broken-giobbe/ceci/(threads)

Thread 1 (2021-04-13):

Make heating algorithm better

electricant, 2021-04-13:
Find a way (and implement it) to have the heating start for a while when the desired temperature is changed. This increases comfort.

For example:
Temperature is 17.6°C. Set point is 17.5°C and the user wants to increase the temperature to 18°C. Assuming +-0.5°C hysteresis the heating won't start until the temperature is below 17.5°C, and this may take a while. It's better to start heating right away and reevaluate the temperature later.

NOTE: the same should happen if the heating system is on and the set temperature is decreased.

electricant, 2022-03-10:
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
Done in mod_thermostat by resetting:

```
state.final_temp = state.target_temp;
state.anticipator_temp = 0.0;
```

After mode and temperature have been updated.

Closed 2022-03-10.
