broken-giobbe/ceci/cece-pcb/cece-pcb.kicad_pcb

## KiCad design cece-pcb/cece-pcb.kicad_pcb (2021-03-26, last stored version)

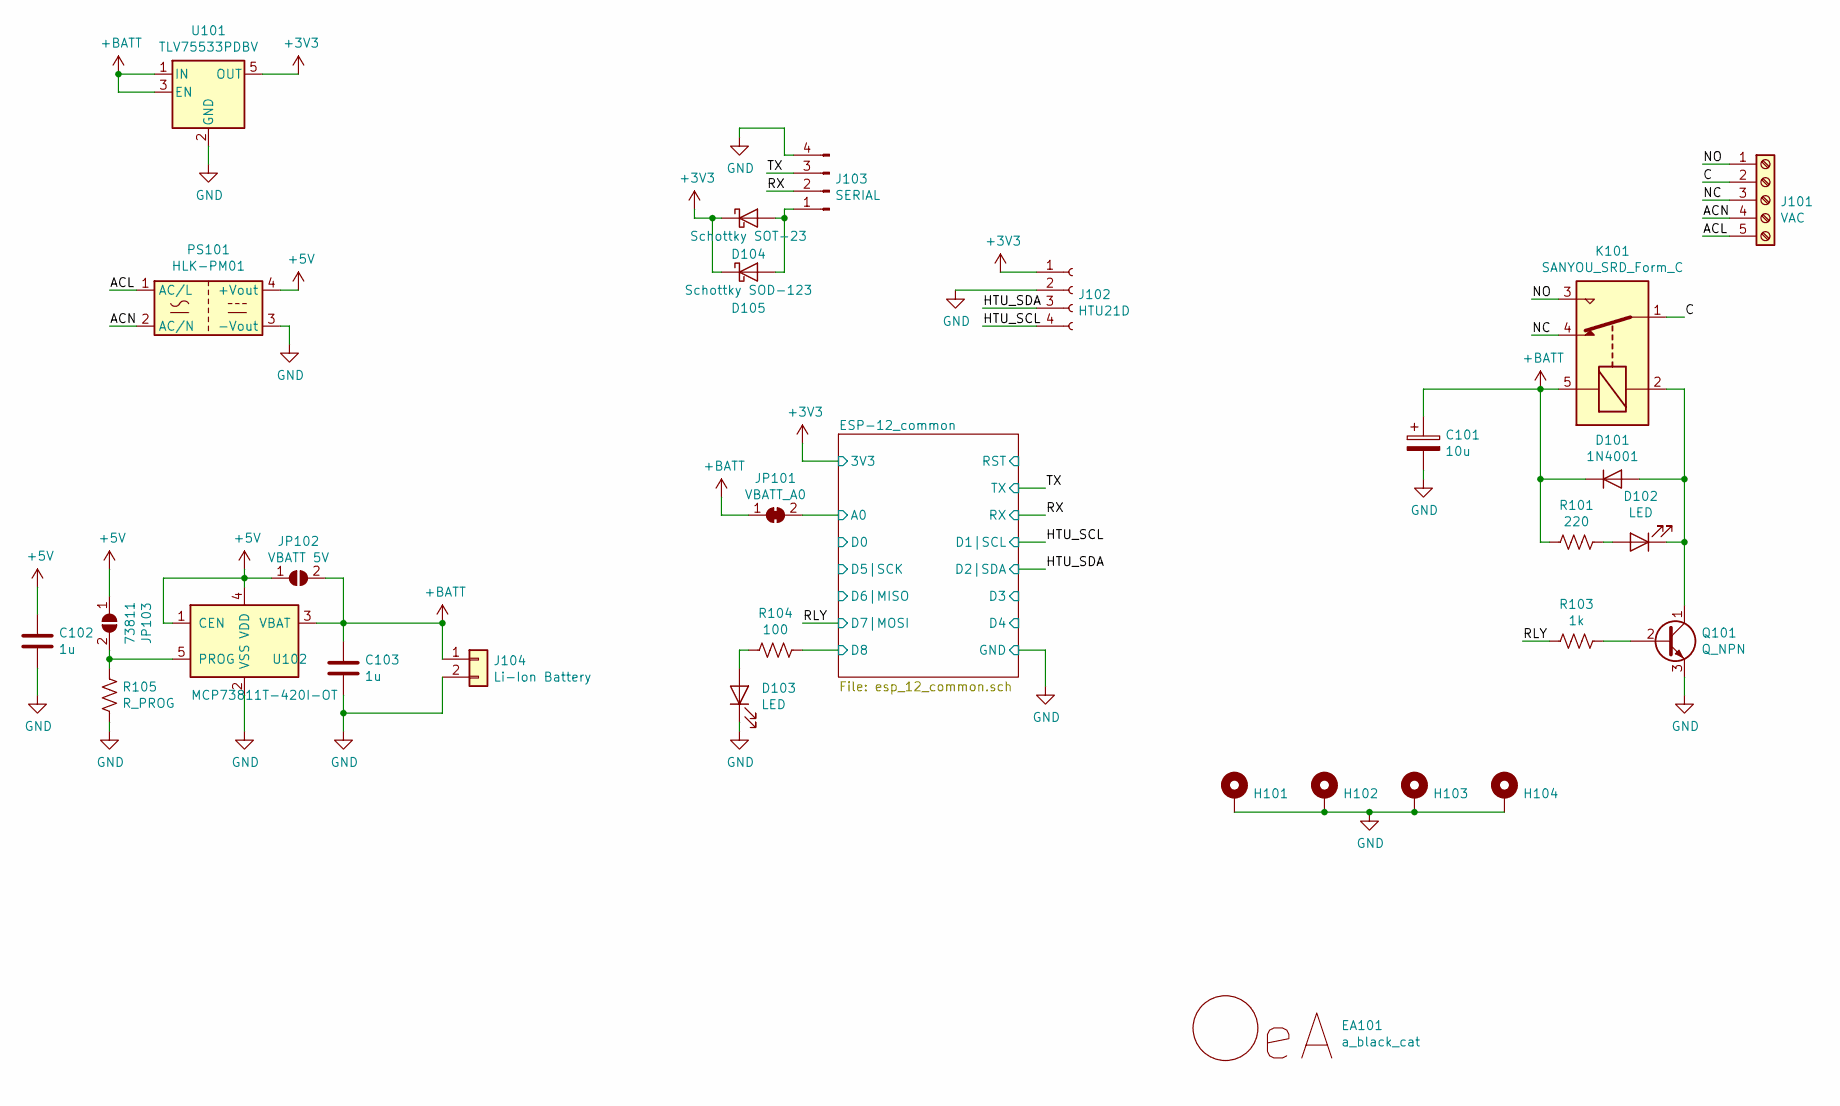
[picture p1: schematic cece-pcb.sch]

Parts:
C101: 10u; C_Radial_D6.3mm_H5.0mm_P2.50mm
C102, C103: 1u; C_Radial_D6.3mm_H5.0mm_P2.50mm
D101: 1N4001; D_DO-41_SOD81_P7.62mm_Horizontal
D102, D103: LED; LED_D3.0mm
D104: Schottky SOT-23; D_SOT-23_ANK
D105: Schottky SOD-123; D_SOD-123F
EA101: a_black_cat
H101, H102, H103, H104: MountingHole_Pad; MountingHole_3.2mm_M3_Pad
J101: VAC; TerminalBlock_bornier-5_P5.08mm
J102: HTU21D; PinHeader_1x04_P2.54mm_Vertical
J103: SERIAL; PinHeader_1x04_P2.54mm_Vertical
J104: Li-Ion Battery; PinHeader_1x02_P2.54mm_Vertical
JP101: VBATT_A0; SolderJumper-2_P1.3mm_Bridged_Pad1.0x1.5mm
JP102: VBATT 5V; SolderJumper-2_P1.3mm_Open_Pad1.0x1.5mm
JP103: 73811; SolderJumper-2_P1.3mm_Open_Pad1.0x1.5mm
K101: SANYOU_SRD_Form_C; Relay_SPDT_SANYOU_SRD_Series_Form_C
PS101: HLK-PM01; Converter_ACDC_HiLink_HLK-PMxx
Q101: Q_NPN; TO-92L_Inline_Wide
R101: 220; R_Axial_DIN0207_L6.3mm_D2.5mm_P7.62mm_Horizontal
R103: 1k; R_Axial_DIN0207_L6.3mm_D2.5mm_P7.62mm_Horizontal
R104: 100; R_Axial_DIN0207_L6.3mm_D2.5mm_P7.62mm_Horizontal
R105: R_PROG; R_0805_2012Metric_Pad1.15x1.40mm_HandSolder
U101: TLV75533PDBV; SOT-23-5
U102: MCP73811T-420I-OT; SOT-23-5

Connections:
+3V3: D104.1 (K), D105.1 (K), J102.1, U101.5 (OUT); also elsewhere on the board
+5V: C102.1, JP102.1 (A), JP103.1 (A), PS101.4 (+Vout), U102.1 (CEN), U102.4 (VDD)
+BATT: C101.1, C103.1, D101.1 (K), J104.1, JP101.1 (A), JP102.2 (B), K101.5, R101.2, U101.1 (IN), U101.3 (EN), U102.3 (VBAT)
/ACL: J101.5, PS101.1 (AC/L)
/ACN: J101.4, PS101.2 (AC/N)
/C: J101.2, K101.1
/ESP-12_common/A0: JP101.2 (B); also elsewhere on the board
/ESP-12_common/D8: R104.1; also elsewhere on the board
/HTU_SCL: J102.4; also elsewhere on the board
/HTU_SDA: J102.3; also elsewhere on the board
/NC: J101.3, K101.4
/NO: J101.1, K101.3
/RLY: R103.2; also elsewhere on the board
/RX: J103.2; also elsewhere on the board
/TX: J103.3; also elsewhere on the board
GND: C101.2, C102.2, C103.2, D103.1 (K), H101.1, H102.1, H103.1, H104.1, J102.2, J103.4, J104.2, PS101.3 (-Vout), Q101.3 (E), R105.2, U101.2 (GND), U102.2 (VSS); also elsewhere on the board
unnamed: D101.2 (A), D102.1 (K), K101.2, Q101.1 (C)
unnamed: D102.2 (A), R101.1
unnamed: D103.2 (A), R104.2
unnamed: D104.2 (A), D105.2 (A), J103.1
unnamed: JP103.2 (B), R105.1, U102.5 (PROG)
unnamed: Q101.2 (B), R103.1

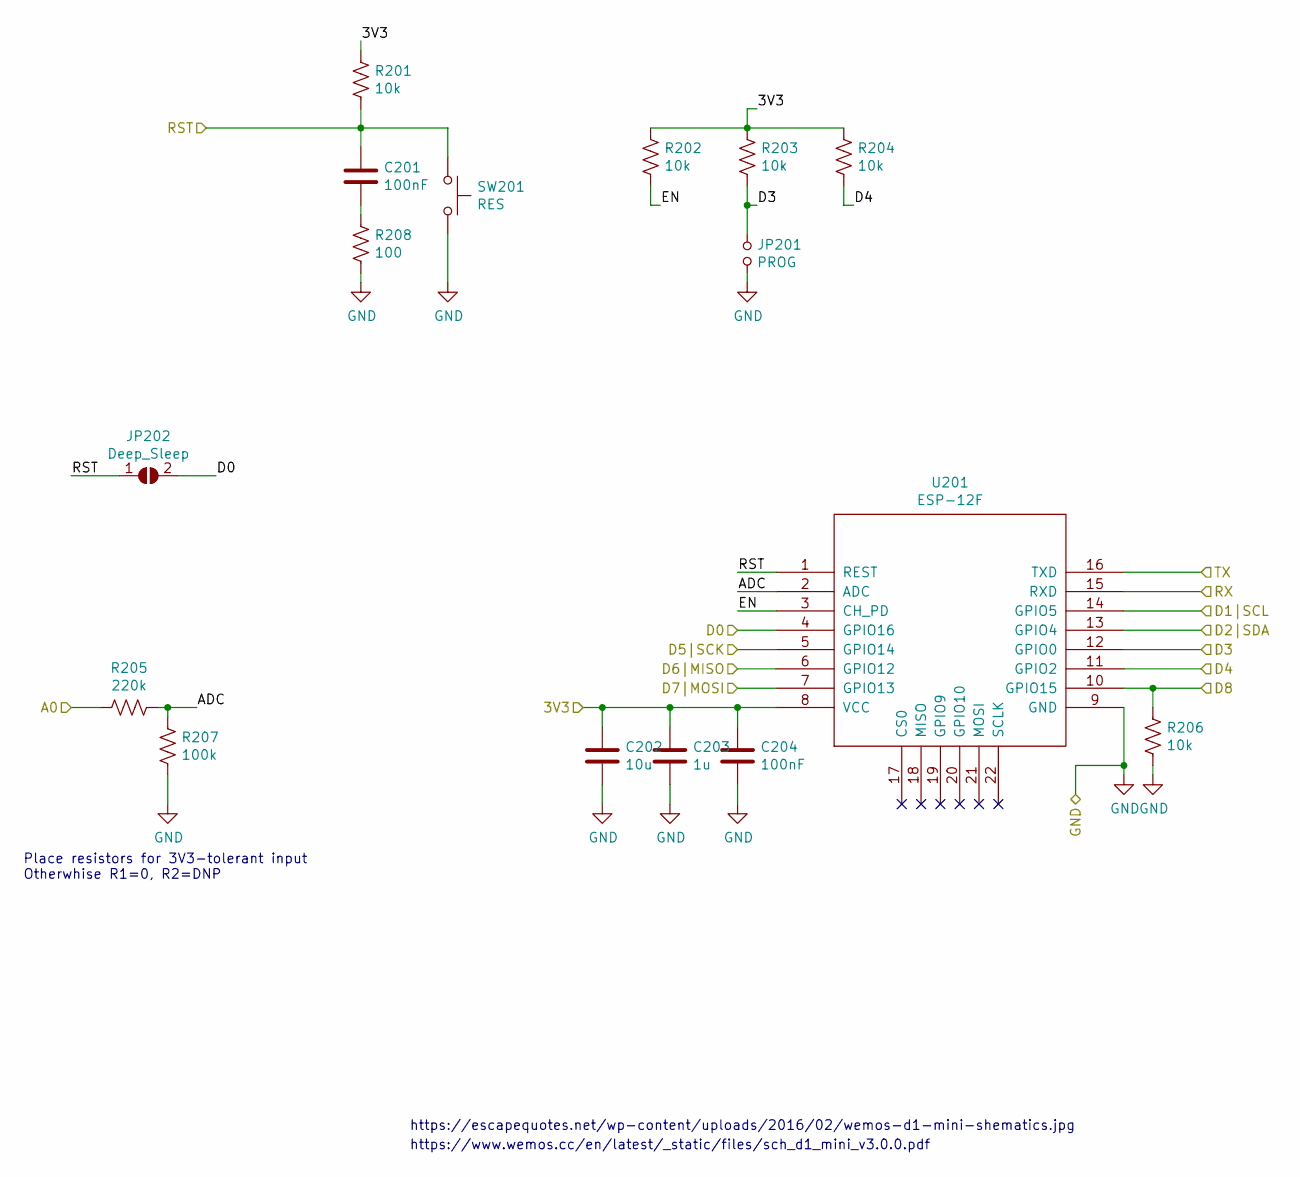
[picture p2: schematic esp_12_common.sch]

Parts:
C201, C204: 100nF; C_Disc_D4.3mm_W1.9mm_P5.00mm
C202: 10u; C_Radial_D6.3mm_H5.0mm_P2.50mm
C203: 1u; C_Radial_D6.3mm_H5.0mm_P2.50mm
JP201: PROG; PinHeader_1x02_P2.54mm_Vertical
JP202: Deep_Sleep; SolderJumper-2_P1.3mm_Open_Pad1.0x1.5mm
R201, R202, R203, R204, R206: 10k; R_Axial_DIN0207_L6.3mm_D2.5mm_P7.62mm_Horizontal
R205: 220k; R_Axial_DIN0207_L6.3mm_D2.5mm_P7.62mm_Horizontal
R207: 100k; R_Axial_DIN0207_L6.3mm_D2.5mm_P7.62mm_Horizontal
R208: 100; R_Axial_DIN0207_L6.3mm_D2.5mm_P7.62mm_Horizontal
SW201: RES; SW_PUSH_6mm
U201: ESP-12F; ESP-12E

Connections:
+3V3: C202.1, C203.1, C204.1, R201.1, R202.2, R203.2, R204.2, U201.8 (VCC); also elsewhere on the board
/ESP-12_common/A0: R205.2; also elsewhere on the board
/ESP-12_common/ADC: R205.1, R207.1, U201.2 (ADC)
/ESP-12_common/D0: JP202.2 (B), U201.4 (GPIO16)
/ESP-12_common/D3: JP201.1, R203.1, U201.12 (GPIO0)
/ESP-12_common/D4: R204.1, U201.11 (GPIO2)
/ESP-12_common/D5|SCK: U201.5 (GPIO14)
/ESP-12_common/D6|MISO: U201.6 (GPIO12)
/ESP-12_common/D8: R206.2, U201.10 (GPIO15); also elsewhere on the board
/ESP-12_common/EN: R202.1, U201.3 (CH_PD)
/ESP-12_common/RST: C201.1, JP202.1 (A), R201.2, SW201.1, U201.1 (REST)
/HTU_SCL: U201.14 (GPIO5); also elsewhere on the board
/HTU_SDA: U201.13 (GPIO4); also elsewhere on the board
/RLY: U201.7 (GPIO13); also elsewhere on the board
/RX: U201.15 (RXD); also elsewhere on the board
/TX: U201.16 (TXD); also elsewhere on the board
GND: C202.2, C203.2, C204.2, JP201.2, R206.1, R207.2, R208.2, SW201.2, U201.9 (GND); also elsewhere on the board
unnamed: C201.2, R208.1

Notes on the sheet:
Place resistors for 3V3-tolerant input Otherwhise R1=0, R2=DNP
https://escapequotes.net/wp-content/uploads/2016/02/wemos-d1-mini-shematics.jpg
https://www.wemos.cc/en/latest/_static/files/sch_d1_mini_v3.0.0.pdf

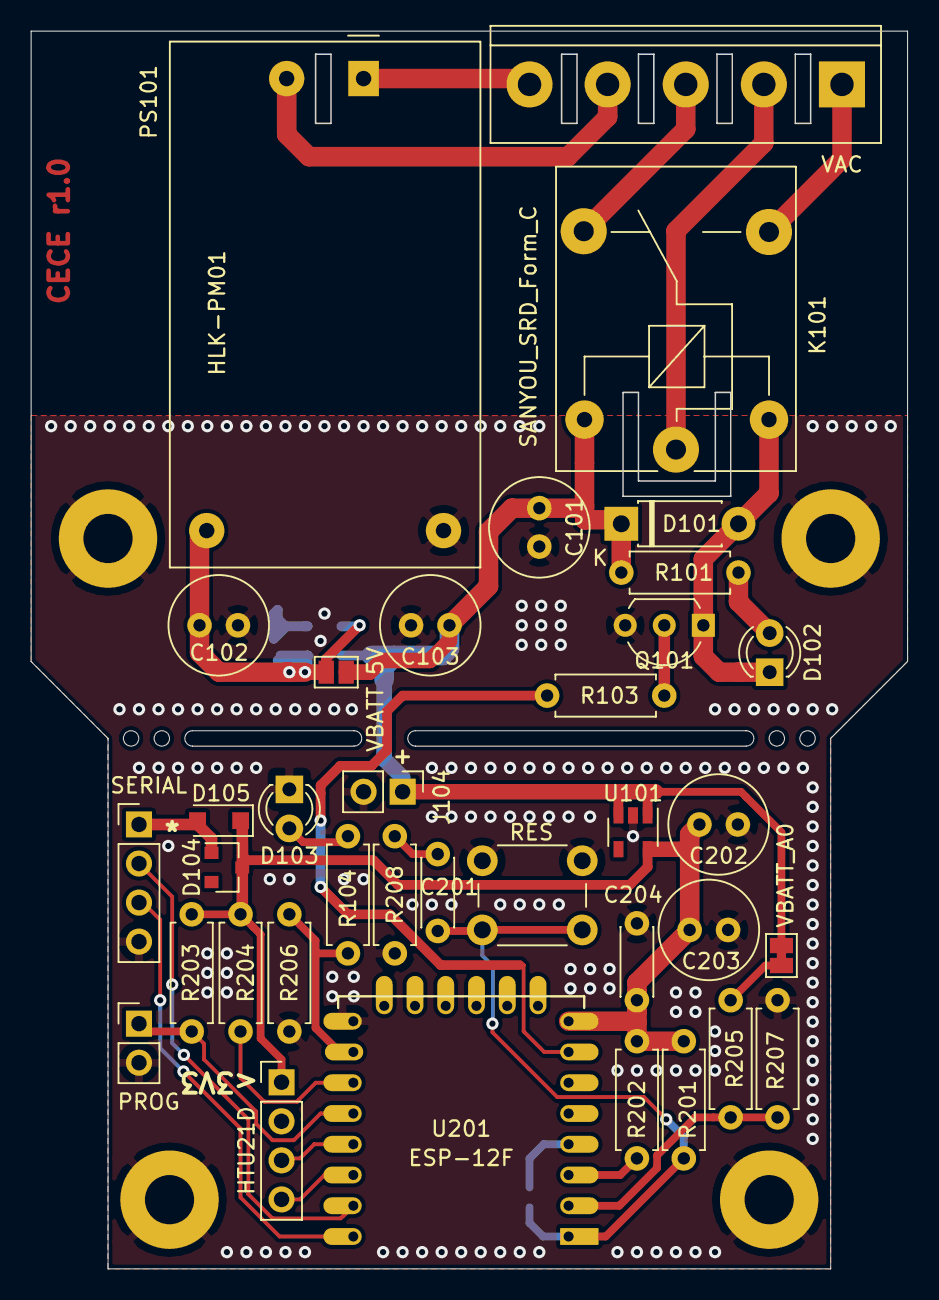
[picture p3: board cece-pcb.kicad_pcb from above]

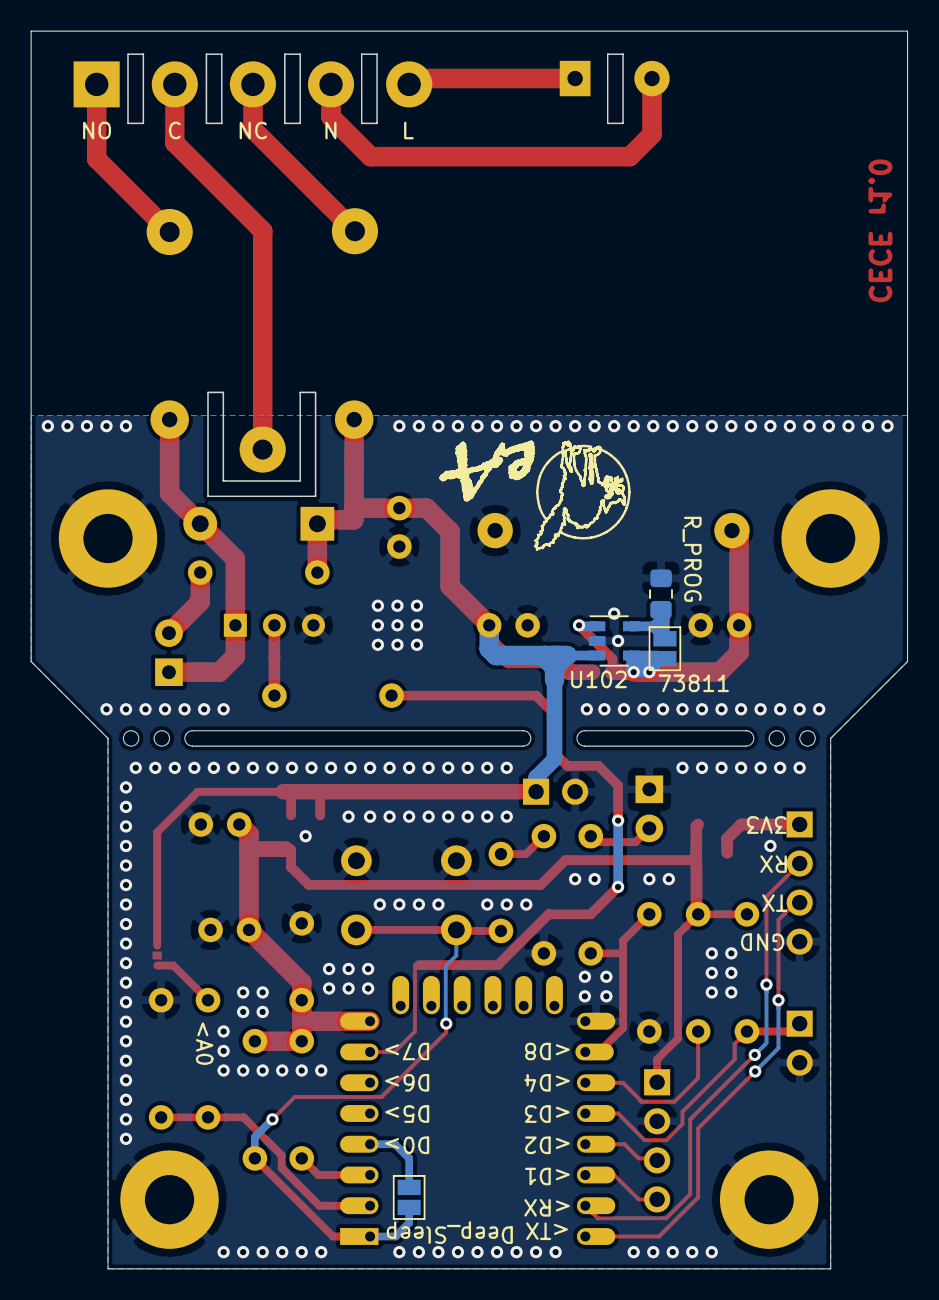
[picture p4: board cece-pcb.kicad_pcb from below]

Board: 2 copper layers, 57.0 x 80.5 mm, 45 parts (5 on the bottom side), 29 nets.
