broken-giobbe/ceci/ceci-firmware/MQTTdispatcher.h

/**
 * Initialize MQTT PubSubClient and listen for MQTT events.
 * (server address and port are set in config.ini)
 * 
 * Once an event is received it is routed to the appropriate callback.
 */

#ifndef MQTT_DISPATCHER_H
#define MQTT_DISPATCHER_H

#include <ESP8266WiFi.h>
#include <PubSubClient.h>

WiFiClient wifiClient;
PubSubClient mqttClient(wifiClient);

// Rate in milliseconds at which the MQTT function loop() is called
// used for keepalive and to react to subscriptions.
#define MQTT_LOOP_RATE 1000L  // for stuff that needs to react to subscriptions immediately
//#define MQTT_LOOP_RATE 1000*(MQTT_KEEPALIVE / 2) // for sensors with no subscriptions

// Size of the buffer for reading/sending MQTT messages
#define MQTT_BUFFER_SIZE 64

// Maximum size for the dispatch table
#define DISPATCH_TABLE_SIZE 5

struct mqtt_msg {
  const char* topic;
  const char* str_msg;
  bool retained;
};
typedef struct mqtt_msg mqtt_msg;

/*
 * Initialize MQTT
 */
void mqtt_init(SPIFFSIniFile* conf);

/*
 * Function used to publish MQTT message strings for a certain topic.
 * 
 * Parameters:
 *     msg -> pointer to a mqtt_msg struct containing the message to send
 */
void mqtt_publish(mqtt_msg* msg);

/*
 * Subscrive to a certain topic and register a callback for it.
 * 
 * Returns a value >=0 on success, -1 otherwise
 */
int mqtt_register_cb(String topic, void (*cb_func)(byte*, size_t));

/*
 * Unsubscrive to a certain topic and unregister its callback
 */
void mqtt_unregister_cb(String topic);

#endif
