broken-giobbe/ceci/(commit log)

2020-11-29 Add firmware and PCB files
    [cece-pcb.kicad_pcb, cece-pcb.sch, esp_12_common.sch]
2020-12-01 Complete ESP-12 part of the PCB
    [cece-pcb.kicad_pcb, cece-pcb.sch, esp_12_common.sch]
2020-12-04 Finish first board revision
    [cece-pcb.kicad_pcb, cece-pcb.sch, esp_12_common.sch]
2020-12-04 Make board DRC-friendly
    [cece-pcb.kicad_pcb]
2020-12-04 Hang the ESP8266 antenna outside of the board for better RF performance
    [cece-pcb.kicad_pcb]
2020-12-04 More touches to the layout. Almost finished
    [cece-pcb.kicad_pcb, cece-pcb.sch]
2020-12-04 better grounding layout for regulator ICs
    [cece-pcb.kicad_pcb]
2020-12-05 Add jumper to send 5V directly to the LDO if no battery is installed
    [cece-pcb.kicad_pcb, cece-pcb.sch, esp_12_common.sch]
2020-12-05 Use SPIFFS to configure each sensor node.
2020-12-06 Add gerber files
    [cece-pcb-B_Cu.gbr, cece-pcb-B_Mask.gbr, cece-pcb-B_Paste.gbr, cece-pcb-B_SilkS.gbr, cece-pcb-Edge_Cuts.gbr, cece-pcb-F_Cu.gbr, cece-pcb-F_Mask.gbr, cece-pcb-F_Paste.gbr]
2020-12-30 Fix wrong footprint for the pin headers
    [cece-pcb.kicad_pcb, cece-pcb.sch, esp_12_common.sch]
2021-01-06 Create gerbers with the fixed pin header size
    [cece-pcb-B_Cu.gbr, cece-pcb-B_Mask.gbr, cece-pcb-B_Paste.gbr, cece-pcb-B_SilkS.gbr, cece-pcb-Edge_Cuts.gbr, cece-pcb-F_Cu.gbr, cece-pcb-F_Mask.gbr, cece-pcb-F_Paste.gbr]
2021-02-03 Update component values
    [cece-pcb.sch]
2021-02-03 Update schematic references to reflect hierarchy
    [cece-pcb.sch, esp_12_common.sch]
2021-02-04 Boards have arrived. Fixed the many mistakes in the schematic
    [cece-pcb.sch, esp_12_common.sch]
2021-02-04 Update PCB
    [cece-pcb.kicad_pcb]
2021-02-08 Better folder structure and lower power consumption during boot
2021-02-09 Reduce sensor resolution a bit for faster measurements
    The least significat digit is thrown out anyway
2021-02-09 Increase thermal relief size for easier hand soldering
    [cece-pcb.kicad_pcb]
2021-02-10 Add temperature offset correction and update example config file
2021-02-10 Temperature offset is a float
2021-02-12 Add diode to protect the seral input when 3V3 are already supplied internally and shuffle stuff around a bit on the layout
    [cece-pcb.kicad_pcb, cece-pcb.sch]
2021-02-13 Add octave simulation files to test the heating algorithms
    [cece-pcb.kicad_pcb]
2021-02-13 Add initial stub code to support controlling the heating system
2021-02-17 Add proper code to control the central heating
2021-02-22 Add resistor to limit peak current in the reset pushbutton. Prevents contact welding
    [cece-pcb.kicad_pcb, esp_12_common.sch]
2021-03-01 Add EA cat signature
    [cece-pcb.kicad_pcb]
2021-03-26 Use new stuff from pol lib
    [cece-pcb.kicad_pcb, cece-pcb.sch]
2021-04-08 Move hardware design files into a submodule to allow for different HW revisions under the same firmware
    [cece-pcb-B_Cu.gbr, cece-pcb-B_Mask.gbr, cece-pcb-B_Paste.gbr, cece-pcb-B_SilkS.gbr, cece-pcb-Edge_Cuts.gbr, cece-pcb-F_Cu.gbr, cece-pcb-F_Mask.gbr, cece-pcb-F_Paste.gbr]
2021-04-08 run mqtt.loop() more often and keep the relay on for at least a fixed amount of time
    [ceci-firmware.ino]
2021-08-25 Deep code refactoring
    To allow for better hardware configurability the code has been deeply
    refactored. Now two different temperature sensors are supported and a UI
    driver is in the working.
    The final goal is having an header file to describe the current hardware
    implementation.
2021-11-07 Build JSON string incrementally according to sensor capabilities
2021-11-09 Add mod_thermostat stub (missing MQTT hooks)
    [MQTTdispatcher.ino, ceci-firmware.ino, mod_sensors.ino, modules.h]
2021-11-10 Use less precision for the LM75 temperature sensor
2021-11-17 Add support for BME680 ambient sensor
2021-11-19 Make MQTT sensor message more compact
2021-11-26 Minor bugfixes + build for cece-fuori
    [AmbientSensor.ino, MQTTdispatcher.h, mod_sensors.ino, mod_thermostat.ino, sysconfig.h]
2021-11-28 Log a message if measurement fails
    [AmbientSensor.ino, mod_sensors.ino]
2021-12-06 Fix wrong MQTT loop rate calculation from keepalive
    [MQTTdispatcher.h]
2022-01-09 Make BME680 measurements faster by not discarding readings to heat up the sensor
2022-03-02 Reduce initial resistance value
2022-03-06 minor tweaks and bugfixes
    [mod_thermostat.ino, sysconfig.h]
2022-12-17 Implement tickless scheduler and various bugfixes
    [mod_thermostat.ino, mod_ui.ino, sysconfig.h]
2022-12-27 Scheduler bugfixes for improved timing accuracy
    [sysconfig.h]
2025-02-22 Use a slower-responding anticipator algorithm to avoid overshoot
    [mod_thermostat.ino]
2026-01-09 Add qd_Sched dependency and rework thermostat logic a bit
    [mod_thermostat.ino]
2026-01-09 Add spreadsheet to run simulation of the effect of teh anticipator values
    [anticipator_calculator.ods]
